Jannled/SmartScale/electronics/SmartScale.jpg

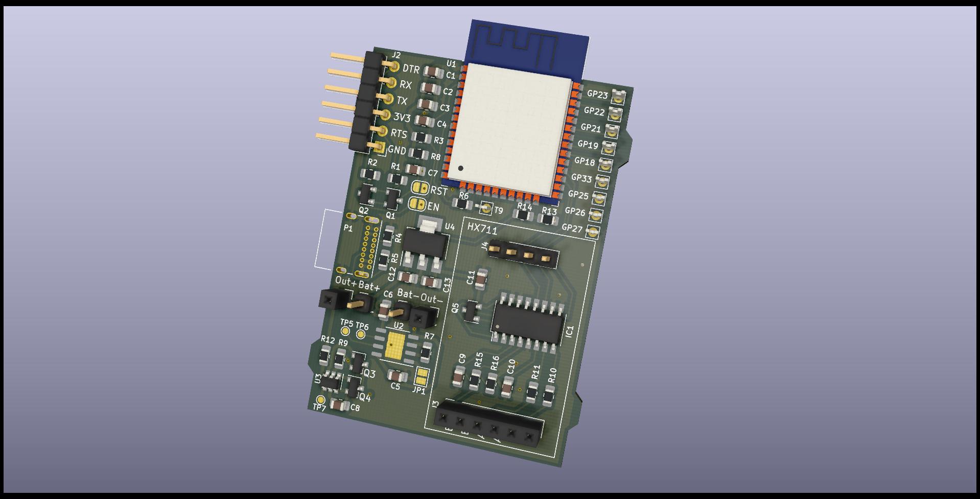
electronics/SmartScale.jpg
