Jannled/SmartScale/electronics/SmartScaleBack.png

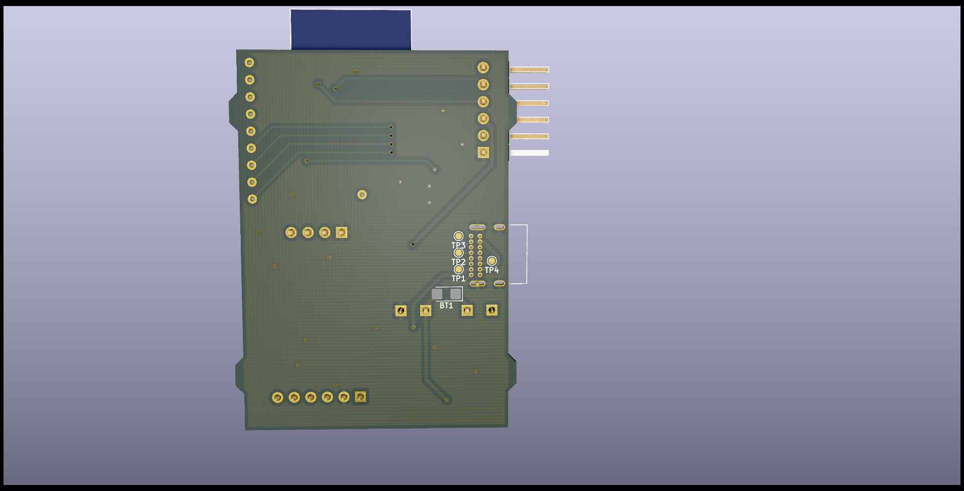
electronics/SmartScaleBack.png
