Jannled/SmartScale/README.md

> [!TIP]
> Archived, since I created a [second version](https://github.com/Jannled/SmartScale2) of this project

# SmartScale
Modification of a kitchen scale with an ESP32 and a HX711 on a custom PCB

# Software
For the development of this project, PlatformIO and KiCad were used.
