Jannled/SmartScale/Nibbler/Nibbler.png

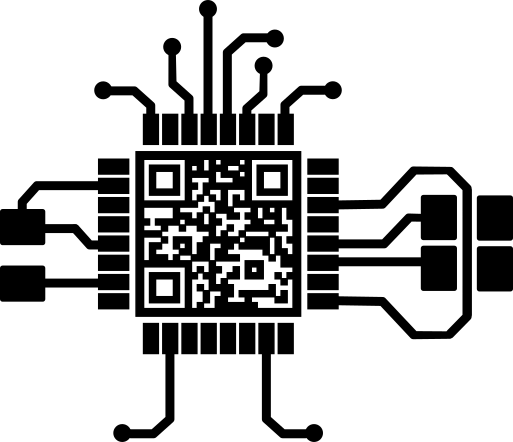
Nibbler/Nibbler.png
