Jannled/SmartScale/case/SmartScale Bottom.step

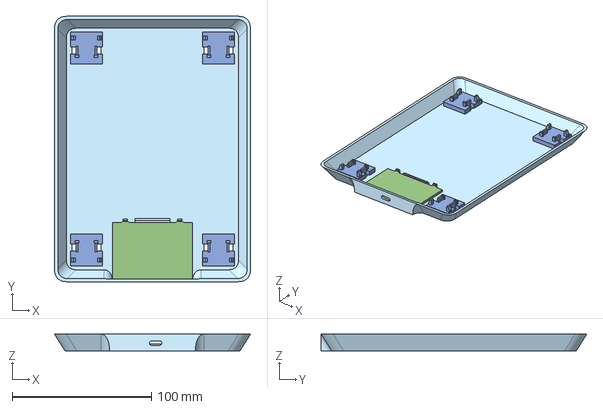
[picture p4: CAD file, 2021-12-02]
case/SmartScale Bottom.step
141.0 x 191.0 x 12.0 mm
