Jannled/SmartScale/Nibbler/Tshirt_hinten_Nibbler.dxf

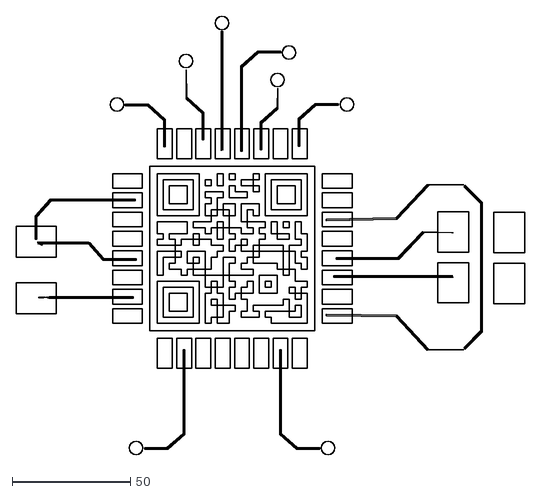
[picture p5: CAD file, 2021-12-15]
Nibbler/Tshirt_hinten_Nibbler.dxf
214.7 x 185.1
