Jannled/SmartScale/(list of files, cad)

Other CAD files:
case/SmartScale-Bottom.stl
