Jannled/SmartScale/electronics/SmartScale.kicad_pcb

## KiCad design electronics/SmartScale.kicad_pcb (2022-03-23)

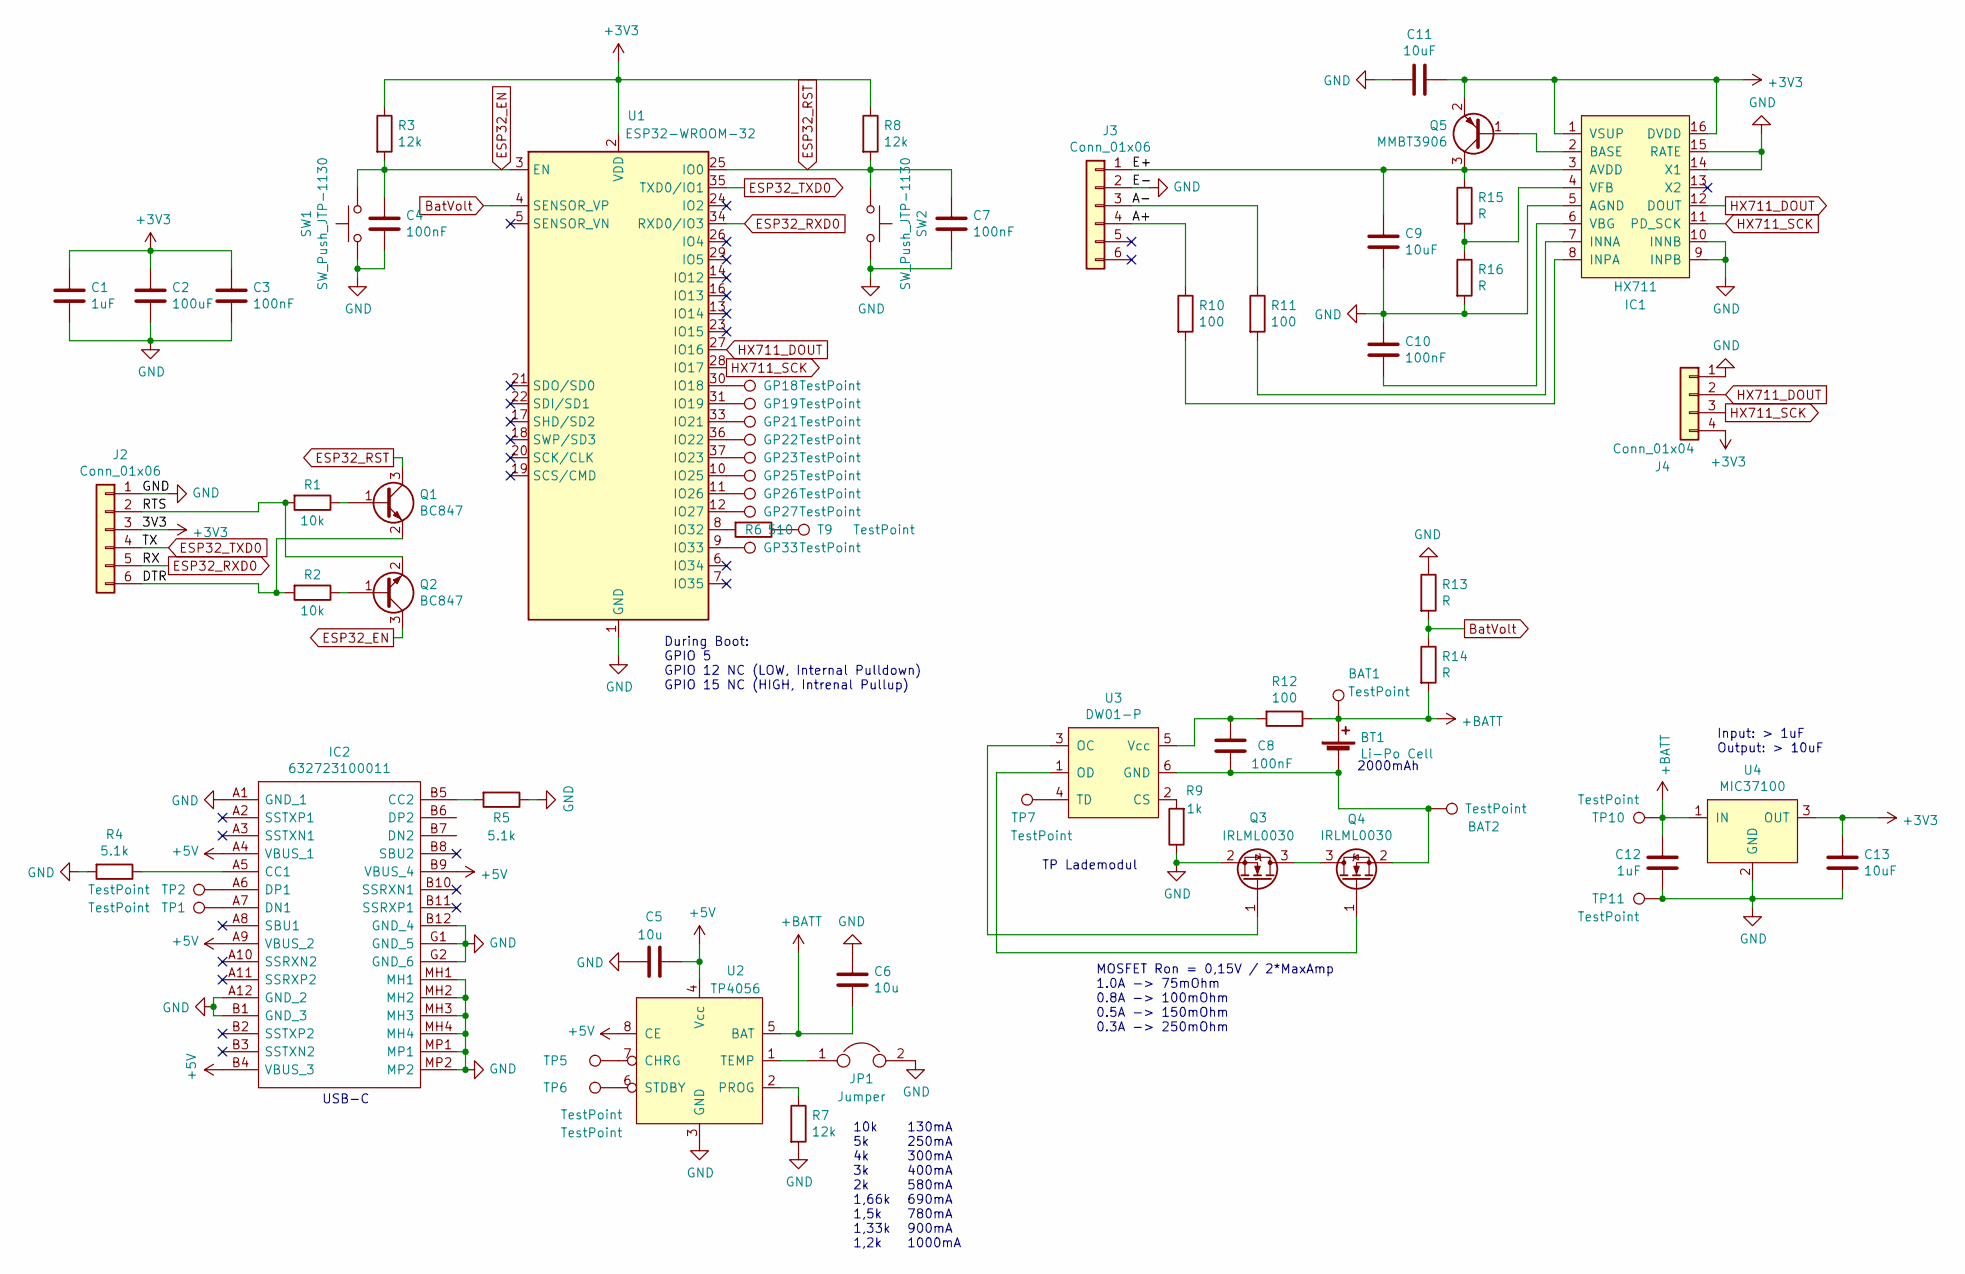
[picture p6: schematic SmartScale.kicad_sch, Smarte Küchenwaage]

Parts:
BAT1, BAT2: TestPoint; PinHeader_1x01_P2.54mm_Vertical
BT1: Li-Po Cell; D_1206_3216Metric_Castellated
C1, C12: 1uF; C_0805_2012Metric_Pad1.18x1.45mm_HandSolder
C2: 100uF; C_0805_2012Metric_Pad1.18x1.45mm_HandSolder
C3, C4, C7, C8, C10: 100nF; C_0805_2012Metric_Pad1.18x1.45mm_HandSolder
C5, C6: 10u; C_0805_2012Metric_Pad1.18x1.45mm_HandSolder
C9, C11, C13: 10uF; C_0805_2012Metric_Pad1.18x1.45mm_HandSolder
GP18, GP19, GP21, GP22, GP23, GP25, GP26, GP27, GP33: TestPoint; Pin_D0.7mm_L6.5mm_W1.8mm_FlatFork
IC1: HX711; SOP-16_4.4x10.4mm_P1.27mm
IC2: 632723100011; Mouser Part Number 710-632723100011
J2: Conn_01x06; PinHeader_1x06_P2.54mm_Horizontal
J3: Conn_01x06; PinSocket_1x06_P2.54mm_Vertical
J4: Conn_01x04; PinHeader_1x04_P2.54mm_Vertical
JP1: Jumper; SolderJumper-2_P1.3mm_Bridged_Pad1.0x1.5mm
Q1, Q2: BC847; SOT-23
Q3, Q4: IRLML0030; SOT-23
Q5: MMBT3906; SOT-23
R1, R2: 10k; R_0805_2012Metric_Pad1.20x1.40mm_HandSolder
R3, R7, R8: 12k; R_0805_2012Metric_Pad1.20x1.40mm_HandSolder
R4, R5: 5.1k; R_0805_2012Metric_Pad1.20x1.40mm_HandSolder
R6: 510; R_0805_2012Metric_Pad1.20x1.40mm_HandSolder
R9: 1k; R_0805_2012Metric_Pad1.20x1.40mm_HandSolder
R10, R11, R12: 100; R_0805_2012Metric_Pad1.20x1.40mm_HandSolder
R13, R14, R15, R16: R; R_0805_2012Metric_Pad1.20x1.40mm_HandSolder
SW1, SW2: SW_Push_JTP-1130; SolderJumper-2_P1.3mm_Open_RoundedPad1.0x1.5mm
T9: TestPoint; Pin_D0.7mm_L6.5mm_W1.8mm_FlatFork
TP1, TP2, TP5, TP6, TP7: TestPoint; TestPoint_Pad_D1.0mm
TP10, TP11: TestPoint; PinSocket_1x01_P2.54mm_Vertical
U1: ESP32-WROOM-32
U2: TP4056; SOP-8_3.9x4.9mm_P1.27mm
U3: DW01-P; SOT-23-6
U4: MIC37100; SOT-223

Connections:
+3V3: C1.1, C2.1, C3.1, C11.1, C13.1, IC1.1 (VSUP), IC1.16 (DVDD), J2.3, J4.4, Q5.2 (E), R3.1, R8.1, U1.2 (VDD), U4.3 (OUT)
+5V: C5.2, IC2.A4 (VBUS_1), IC2.A9 (VBUS_2), IC2.B4 (VBUS_3), IC2.B9 (VBUS_4), U2.4 (Vcc), U2.8 (CE); also elsewhere on the board
+BATT: BAT1.1, BT1.1 (+), C6.2, C12.2, R12.1, R14.2, TP10.1, U2.5 (BAT), U4.1 (IN)
/A+: J3.4, R10.1
/A-: J3.3, R11.1
/DTR: J2.6, Q1.2 (E), R2.2
/E+: C9.1, IC1.3 (AVDD), J3.1, Q5.3 (C), R15.1
/RTS: J2.2, Q2.2 (E), R1.2
BatVolt: R13.2, R14.1, U1.4 (SENSOR_VP)
ESP32_EN: C4.1, Q2.3 (C), R3.2, SW1.2, U1.3 (EN)
ESP32_RST: C7.1, Q1.3 (C), R8.2, SW2.2, U1.25 (IO0)
ESP32_RXD0: J2.5, U1.34 (RXD0/IO3)
ESP32_TXD0: J2.4, U1.35 (TXD0/IO1)
GND: C1.2, C2.2, C3.2, C4.2, C5.1, C6.1, C7.2, C9.2, C10.1, C11.2, C12.1, C13.2, IC1.5 (AGND), IC1.9 (INPB), IC1.10 (INNB), IC1.14 (X1), IC1.15 (RATE), IC2.A1 (GND_1), IC2.A12 (GND_2), IC2.B1 (GND_3), IC2.B12 (GND_4), IC2.G1 (GND_5), IC2.G2 (GND_6), IC2.MH1, IC2.MH2, IC2.MH3, IC2.MH4, IC2.MP1, IC2.MP2, J2.1, J3.2, J4.1, JP1.2, Q3.2 (S), R4.2, R5.1, R7.2, R9.1, R13.1, R16.2, SW1.1, SW2.1, TP11.1, U1.1 (GND), U1.15 (GND), U1.38 (GND), U1.39 (GND), U2.3 (GND), U4.2 (GND); also elsewhere on the board
HX711_DOUT: IC1.12 (DOUT), J4.2, U1.27 (IO16)
HX711_SCK: IC1.11 (PD_SCK), J4.3, U1.28 (IO17)
unnamed: BAT2.1, BT1.2 (-), C8.1, Q4.2 (S), U3.6 (GND)
unnamed: C8.2, R12.2, U3.5 (Vcc)
unnamed: C10.2, IC1.6 (VBG)
unnamed: GP18.1, U1.30 (IO18)
unnamed: GP19.1, U1.31 (IO19)
unnamed: GP21.1, U1.33 (IO21)
unnamed: GP22.1, U1.36 (IO22)
unnamed: GP23.1, U1.37 (IO23)
unnamed: GP25.1, U1.10 (IO25)
unnamed: GP26.1, U1.11 (IO26)
unnamed: GP27.1, U1.12 (IO27)
unnamed: GP33.1, U1.9 (IO33)
unnamed: IC1.2 (BASE), Q5.1 (B)
unnamed: IC1.4 (VFB), R15.2, R16.1
unnamed: IC1.7 (INNA), R11.2
unnamed: IC1.8 (INPA), R10.2
unnamed: IC2.A5 (CC1), R4.1
unnamed: IC2.A6 (DP1), TP2.1
unnamed: IC2.A7 (DN1), TP1.1
unnamed: IC2.B5 (CC2), R5.2
unnamed: JP1.1, U2.1 (TEMP)
unnamed: Q1.1 (B), R1.1
unnamed: Q2.1 (B), R2.1
unnamed: Q3.1 (G), U3.3 (OC)
unnamed: Q3.3 (D), Q4.3 (D)
unnamed: Q4.1 (G), U3.1 (OD)
unnamed: R6.1, T9.1
unnamed: R6.2, U1.8 (IO32)
unnamed: R7.1, U2.2 (PROG)
unnamed: R9.2, U3.2 (CS)
unnamed: TP5.1, U2.7 (CHRG)
unnamed: TP6.1, U2.6 (STDBY)
unnamed: TP7.1, U3.4 (TD)

Notes on the sheet:
TP Lademodul
USB-C
During Boot: GPIO 5 GPIO 12 NC (LOW, Internal Pulldown) GPIO 15 NC (HIGH, Intrenal Pullup)
MOSFET Ron = 0,15V / 2*MaxAmp 1.0A -> 75mOhm 0.8A -> 100mOhm 0.5A -> 150mOhm 0.3A -> 250mOhm
Input: > 1uF Output: > 10uF
130mA 250mA 300mA 400mA 580mA 690mA 780mA 900mA 1000mA
10k 5k 4k 3k 2k 1,66k 1,5k 1,33k 1,2k
2000mAh

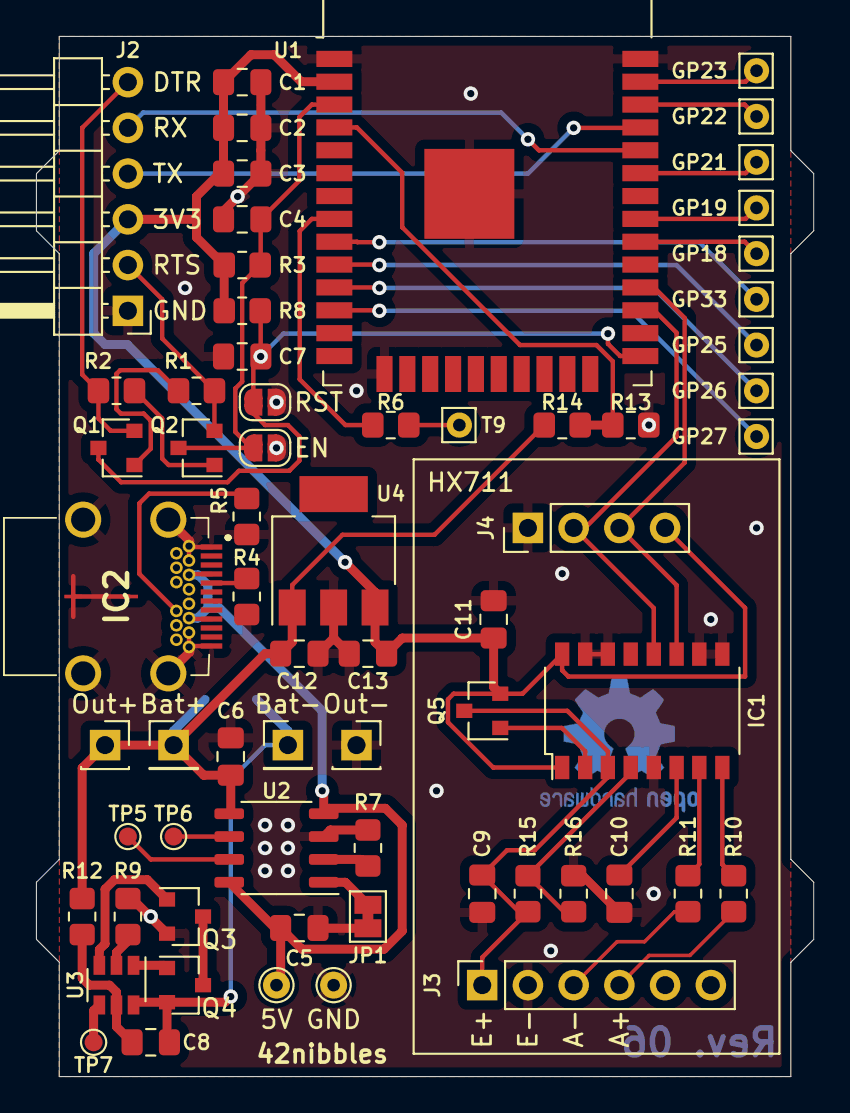
[picture p7: board SmartScale.kicad_pcb from above]

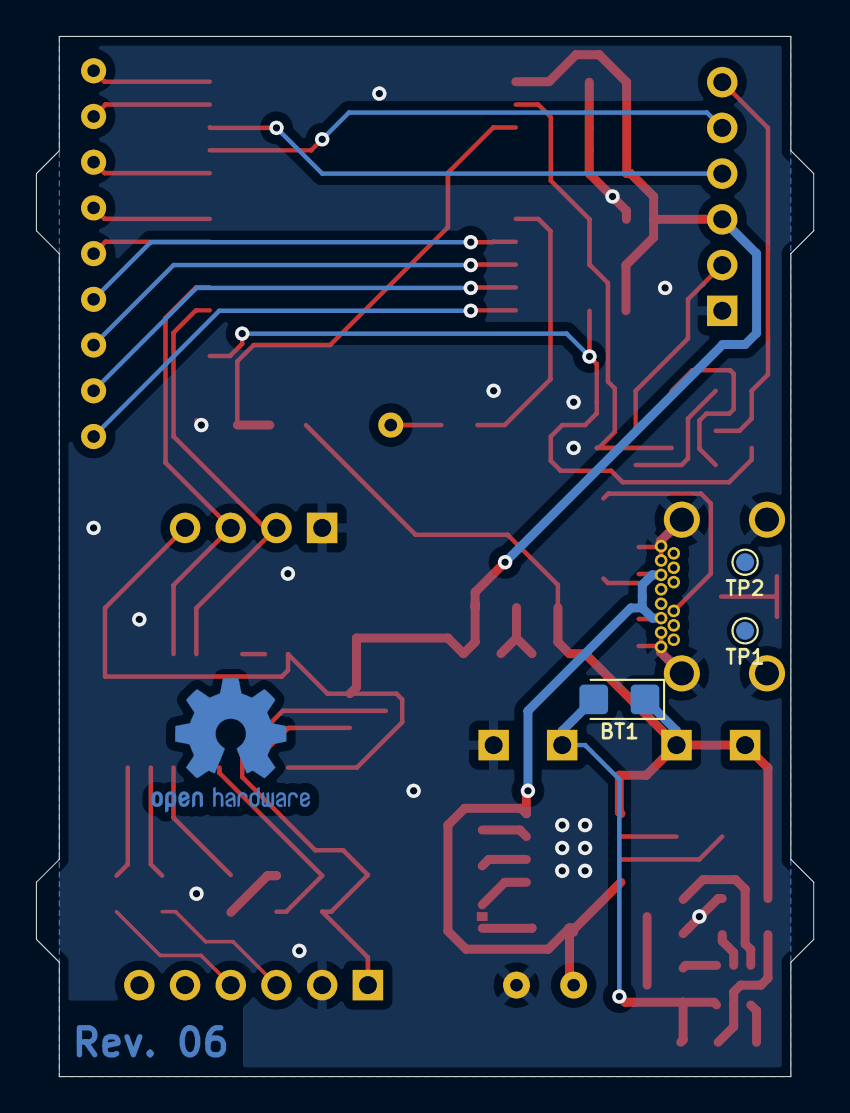
[picture p8: board SmartScale.kicad_pcb from below]

Board: 2 copper layers, 43.2 x 57.8 mm, 68 parts (3 on the bottom side), 49 nets.

Other parts of the board:
5V: TestPoint_THTPad_D1.5mm_Drill0.7mm
GND: TestPoint_THTPad_D1.5mm_Drill0.7mm

Their connections:
+5V: 5V.1; also elsewhere on the board
GND: GND.1; also elsewhere on the board
