Jannled/SmartScale/(commit log)

2021-10-24 Print precise divider
2021-10-25 Push PCB
    [SmartScale.csv, SmartScale.kicad_pcb, SmartScale.sch]
2021-12-02 Pushed casing and updated PCB
    [SmartScale Bottom.step, SmartScale-Bottom.stl, SmartScale.kicad_pcb, SmartScale.sch]
2021-12-15 PCB Rev 5
    - Added 42Nibbles QR Code
    - Moved 5V connection
    [SmartScale-B_Cu.gbr, SmartScale-B_Mask.gbr, SmartScale-Edge_Cuts.gbr, SmartScale-F_Cu.gbr, SmartScale-F_Mask.gbr, SmartScale-F_Paste.gbr, SmartScale-F_SilkS.gbr, SmartScale-NPTH.drl]
2022-01-19 Pushing changes made at my University
    [SmartScale.csv, SmartScale.kicad_pcb, SmartScale.kicad_sch]
2022-03-23 PCB Rev 6, fixed error with flashing
    [SmartScale.kicad_pcb, SmartScale.kicad_sch]
2022-07-12 Intermediate push, dunno what I just broke but whatever
    [SmartScale.kicad_sch]
2023-05-09 Push after a long time
    [SmartScale.kicad_sch]
2023-05-17 Try to fix WiFi AP
    [index.html.h, main.cpp, main.hpp]
